JuneyBoy/Digital-Alarm-Clock/final_project_breadboard.JPG

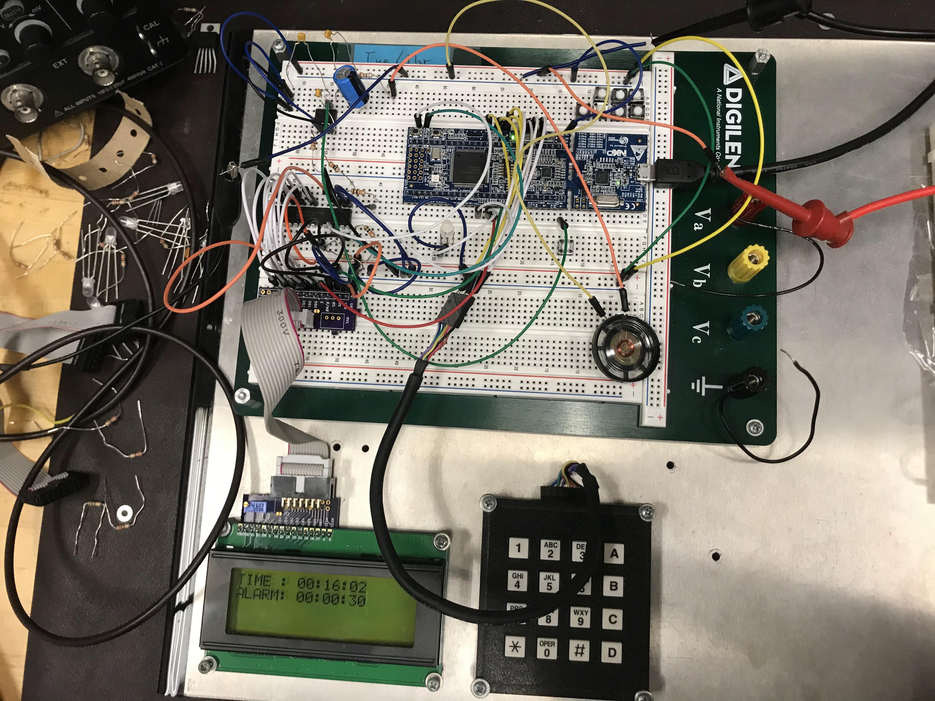
final_project_breadboard.JPG
