JuneyBoy/Digital-Alarm-Clock/final_project_poster.JPG

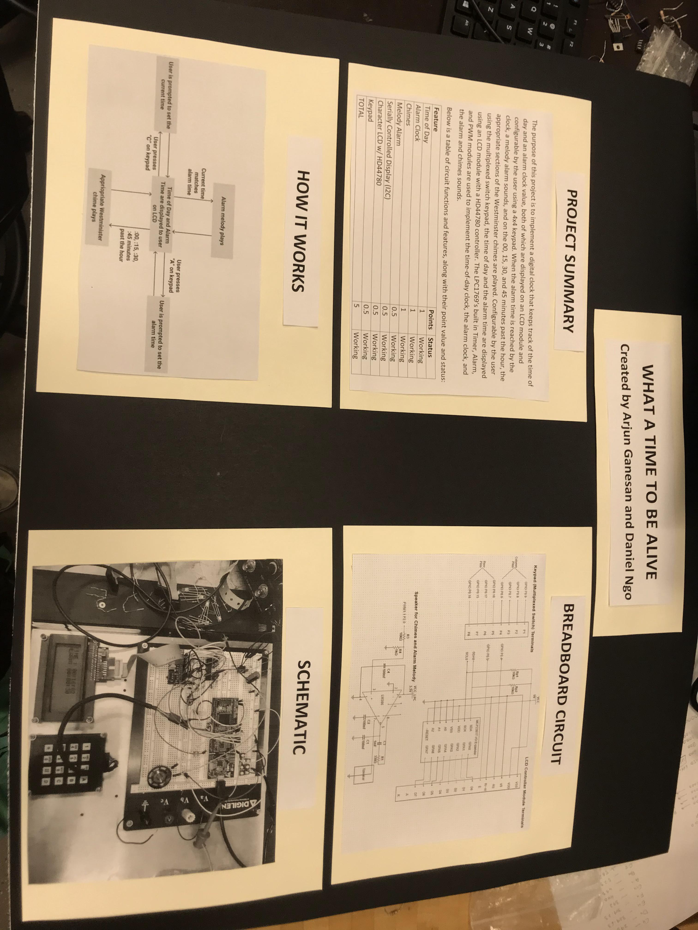
final_project_poster.JPG
