JuneyBoy/Digital-Alarm-Clock/(list of files, drawings)

Other design files:
Final_Project_Schematic.ms14
